revregi/SEM15_villogo/SEM15.kicad_pcb

## KiCad design SEM15.kicad_pcb (2023-10-27)

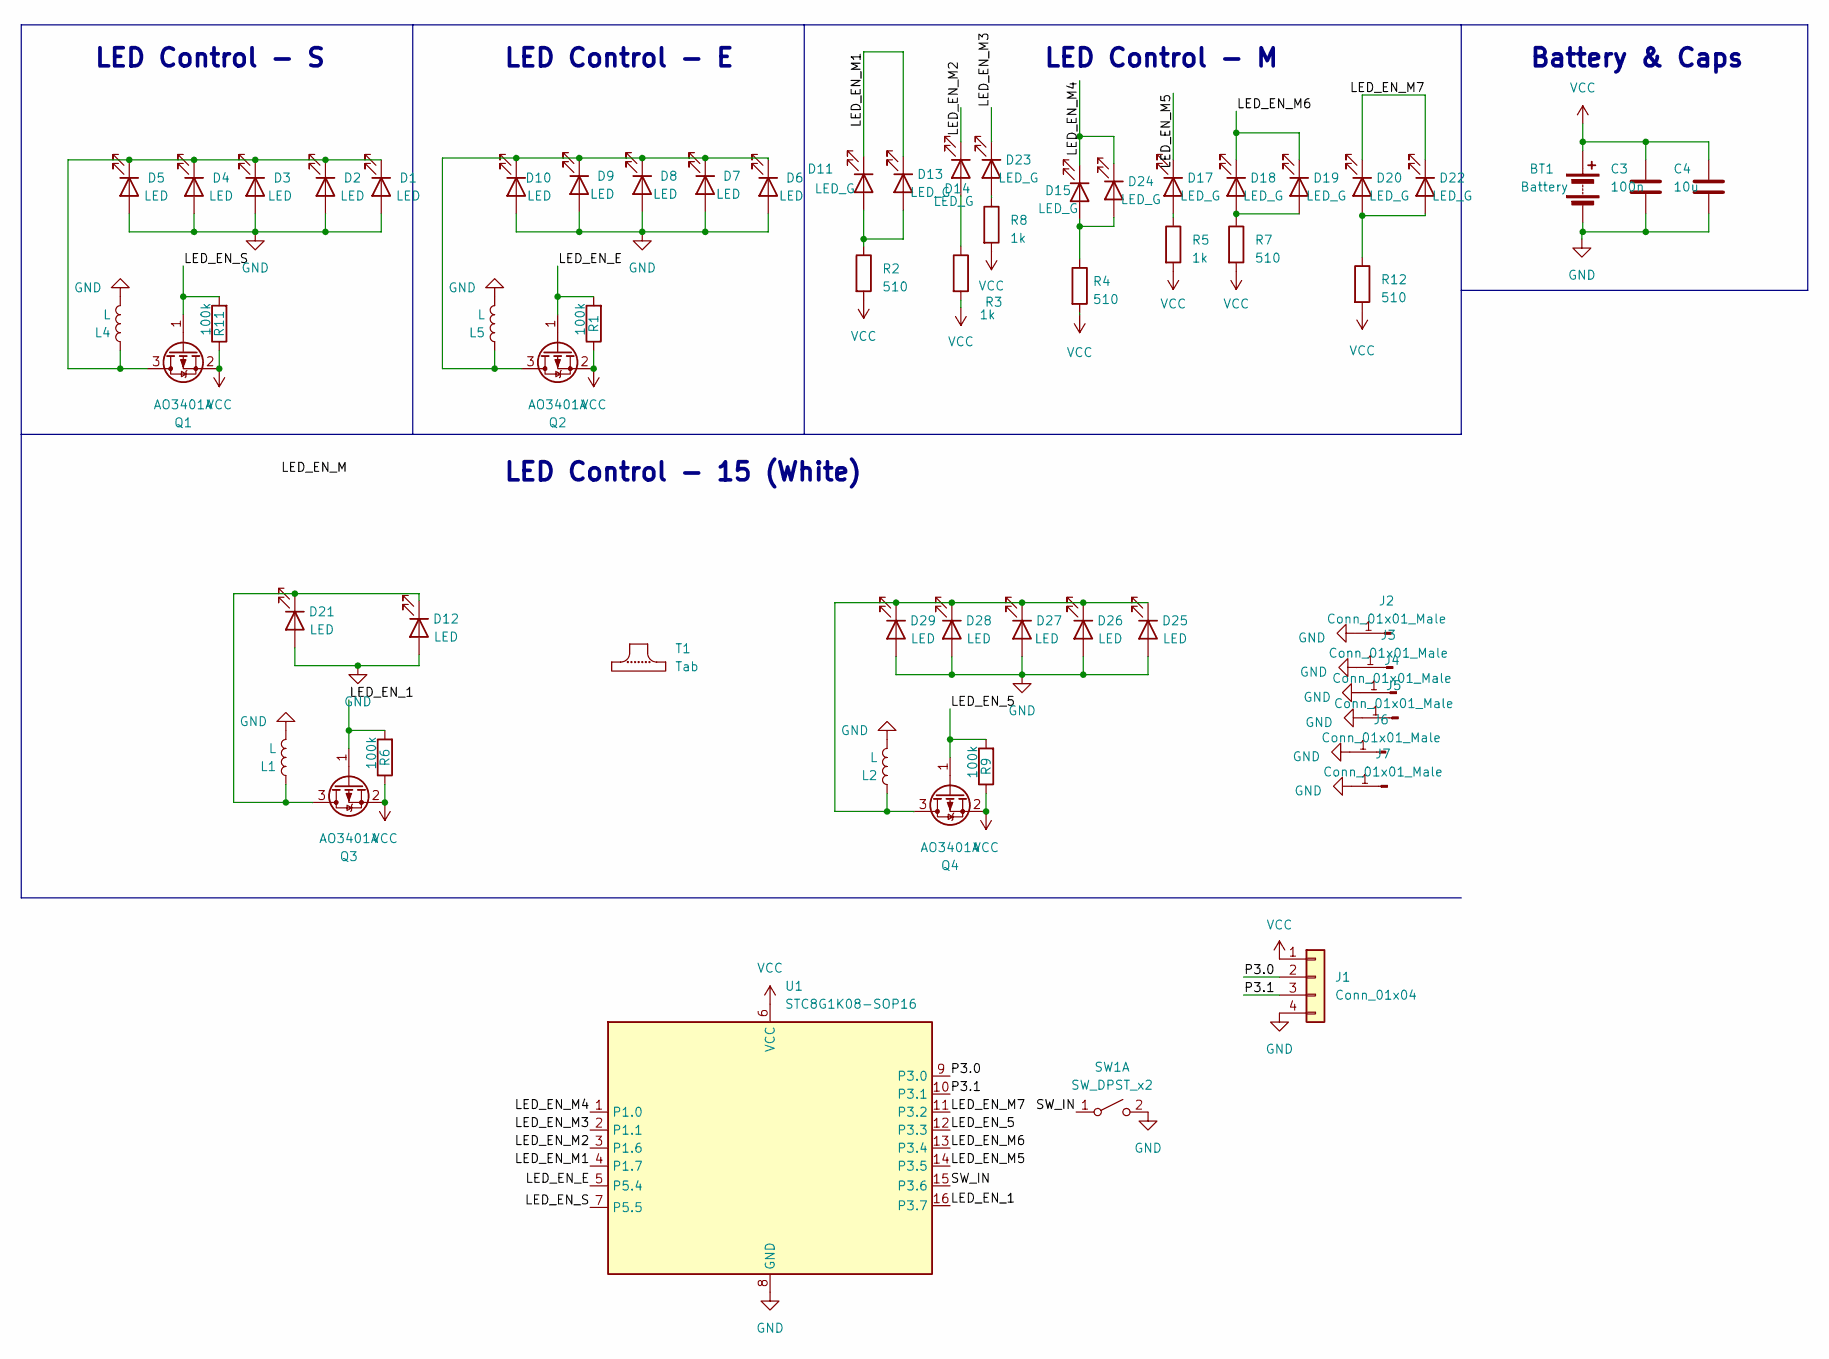
[picture p1: schematic SEM15.kicad_sch]

Parts:
BT1: Battery; CR2032_Holder
C3: 100n; C_0805_2012Metric
C4: 10u; C_0805_2012Metric
D1, D2, D3, D4, D5, D6, D7, D8, D9, D10, D12, D21, D25, D26, D27, D28, D29: LED; LED_0805_2012Metric
D11, D13, D14, D15, D17, D18, D19, D20, D22, D23, D24: LED_G; LED_0805_2012Metric
J1: Conn_01x04; PinHeader_1x04_P1.27mm_Vertical
J2, J3, J4, J5, J6, J7: Conn_01x01_Male; PinHeader_1x01_P2.54mm_Vertical
L1, L2, L4, L5: L; L_1008_2520Metric
Q1, Q2, Q3, Q4: AO3401A; SOT-23
R1, R6, R9, R11: 100k; R_0603_1608Metric
R2, R4, R7, R12: 510; R_0603_1608Metric
R3, R5, R8: 1k; R_0603_1608Metric
SW1: SW_DPST_x2; SW_Push_TS-1187A
T1: Tab
U1: STC8G1K08-SOP16; STC_SOP-16_3.9x9.9mm_P1.27mm

Connections:
/LED_EN_1: Q3.1 (G), R6.2, U1.16 (P3.7)
/LED_EN_5: Q4.1 (G), R9.2, U1.12 (P3.3)
/LED_EN_E: Q2.1 (G), R1.2, U1.5 (P5.4)
/LED_EN_M1: D11.1 (K), D13.1 (K), U1.4 (P1.7)
/LED_EN_M2: D14.1 (K), U1.3 (P1.6)
/LED_EN_M3: D23.1 (K), U1.2 (P1.1)
/LED_EN_M4: D15.1 (K), D24.1 (K), U1.1 (P1.0)
/LED_EN_M5: D17.1 (K), U1.14 (P3.5)
/LED_EN_M6: D18.1 (K), D19.1 (K), U1.13 (P3.4)
/LED_EN_M7: D20.1 (K), D22.1 (K), U1.11 (P3.2)
/LED_EN_S: Q1.1 (G), R11.2, U1.7 (P5.5)
/P3.0: J1.2, U1.9 (P3.0)
/P3.1: J1.3, U1.10 (P3.1)
/SW_IN: SW1.1 (A), U1.15 (P3.6)
GND: BT1.2 (-), C3.2, C4.2, D1.2 (A), D2.2 (A), D3.2 (A), D4.2 (A), D5.2 (A), D6.2 (A), D7.2 (A), D8.2 (A), D9.2 (A), D10.2 (A), D12.2 (A), D21.2 (A), D25.2 (A), D26.2 (A), D27.2 (A), D28.2 (A), D29.2 (A), J1.4, J2.1, J3.1, J4.1, J5.1, J6.1, J7.1, L1.2, L2.2, L4.2, L5.2, SW1.2 (B), U1.8 (GND); also elsewhere on the board
unnamed: D1.1 (K), D2.1 (K), D3.1 (K), D4.1 (K), D5.1 (K), L4.1, Q1.3 (D)
unnamed: D6.1 (K), D7.1 (K), D8.1 (K), D9.1 (K), D10.1 (K), L5.1, Q2.3 (D)
unnamed: D11.2 (A), D13.2 (A), R2.1
unnamed: D12.1 (K), D21.1 (K), L1.1, Q3.3 (D)
unnamed: D14.2 (A), R3.1
unnamed: D15.2 (A), D24.2 (A), R4.1
unnamed: D17.2 (A), R5.1
unnamed: D18.2 (A), D19.2 (A), R7.1
unnamed: D20.2 (A), D22.2 (A), R12.1
unnamed: D23.2 (A), R8.1
unnamed: D25.1 (K), D26.1 (K), D27.1 (K), D28.1 (K), D29.1 (K), L2.1, Q4.3 (D)
VCC: BT1.1 (+), C3.1, C4.1, J1.1, Q1.2 (S), Q2.2 (S), Q3.2 (S), Q4.2 (S), R1.1, R2.2, R3.2, R4.2, R5.2, R6.1, R7.2, R8.2, R9.1, R11.1, R12.2, U1.6 (VCC)

Notes on the sheet:
LED Control - S
LED Control - E
LED Control - M
Battery & Caps
LED Control - 15 (White)

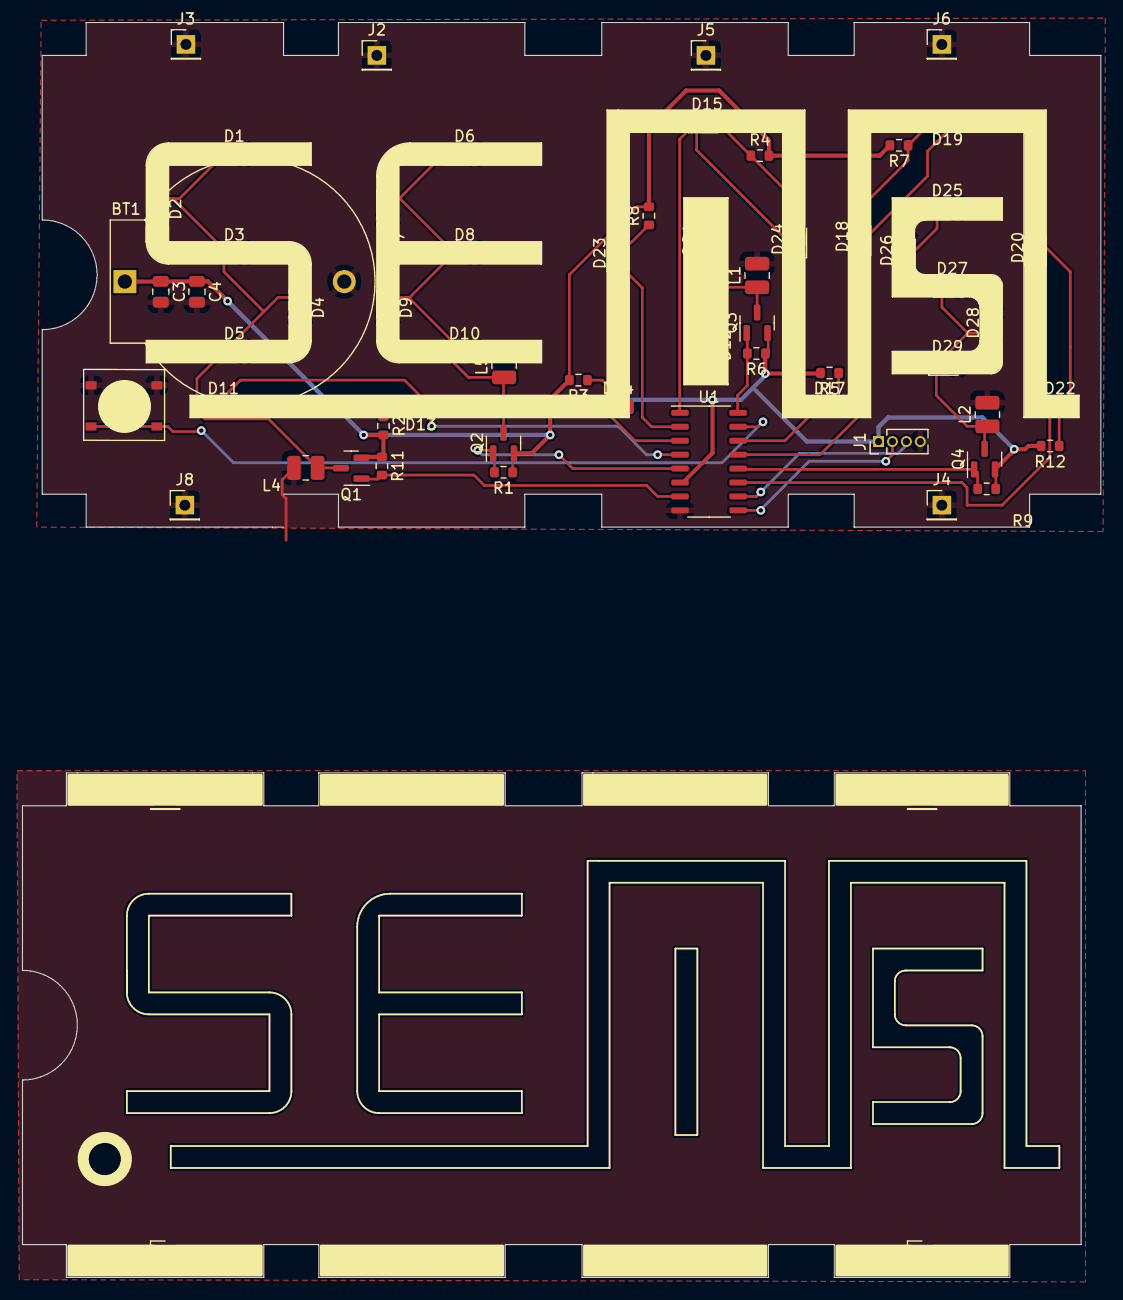
[picture p2: board SEM15.kicad_pcb from above]

Board: 2 copper layers, 98.3 x 114.4 mm, 79 parts (0 on the bottom side), 27 nets.

Other parts of the board:
J2#2, J5#2, J8, J9: Conn_01x01_Male; PinHeader_1x01_P2.54mm_Vertical
T1#2, T1#3, T1#4, T1#5, T1#6, T1#7, T1#8, T1#9, T1#10, T1#11, T1#12, T1#13, T1#14, T1#15, T1#16: Tab

Their connections:
GND: J5#2.1, J8.1; also elsewhere on the board
