revregi/SEM15_villogo/firmware/src/rgbled.h

/*! *******************************************************************************************************
* Copyright (c) 2022 Hekk_Elek
*
* \file rgbled.h
*
* \brief RGB LED driver using current-mode pulse control
*
* \author Hekk_Elek
*
**********************************************************************************************************/
#ifndef RGBLED_H
#define RGBLED_H

/***************************************< Includes >**************************************/
#include "types.h"


/***************************************< Definitions >**************************************/
#define NUM_RGBLED_COLORS   (4u)  //!< Number of colors the RGB LED array has


/***************************************< Types >**************************************/


/***************************************< Constants >**************************************/


/***************************************< Global variables >**************************************/
extern volatile U8 gau8RGBLEDs[ NUM_RGBLED_COLORS ];


/***************************************< Public functions >**************************************/
void RGBLED_Init( void );
void RGBLED_Interrupt( void );


#endif /* RGBLED_H */

/***************************************< End of file >**************************************/
