revregi/SEM15_villogo/(commit log)

2023-10-22 rgb es feher led meghajtasa, mikrovezerlo, pcb-n alkatreszrendezgets
    [SEM15.kicad_pcb, SEM15.kicad_sch]
2023-10-23 sch kesz
    [SEM15.kicad_pcb, SEM15.kicad_sch]
2023-10-24 pcb nagyreszt
    [SEM15.kicad_pcb, SEM15.kicad_sch]
2023-10-26 Panelizalas, BOM elkezdve.
    [SEM15.kicad_pcb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]
2023-10-26 BOM terv
    [SEM15.kicad_sch, SEM15_BOM_terv.csv]
2023-10-26 uj gomb, kivagas
    [SEM15.kicad_pcb, SEM15.kicad_sch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]
2023-10-26 top add silkscreen and fill other side
    [top.kicad_pcb]
2023-10-26 gerberek, bom
    [SEM15.kicad_pcb, SEM15.kicad_sch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]
2023-10-27 sent to jlc
    [SEM15.kicad_pcb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]
2023-11-19 Ported battery charge display.
